ridoluc/RunTiny/hardware/schematics.pdf

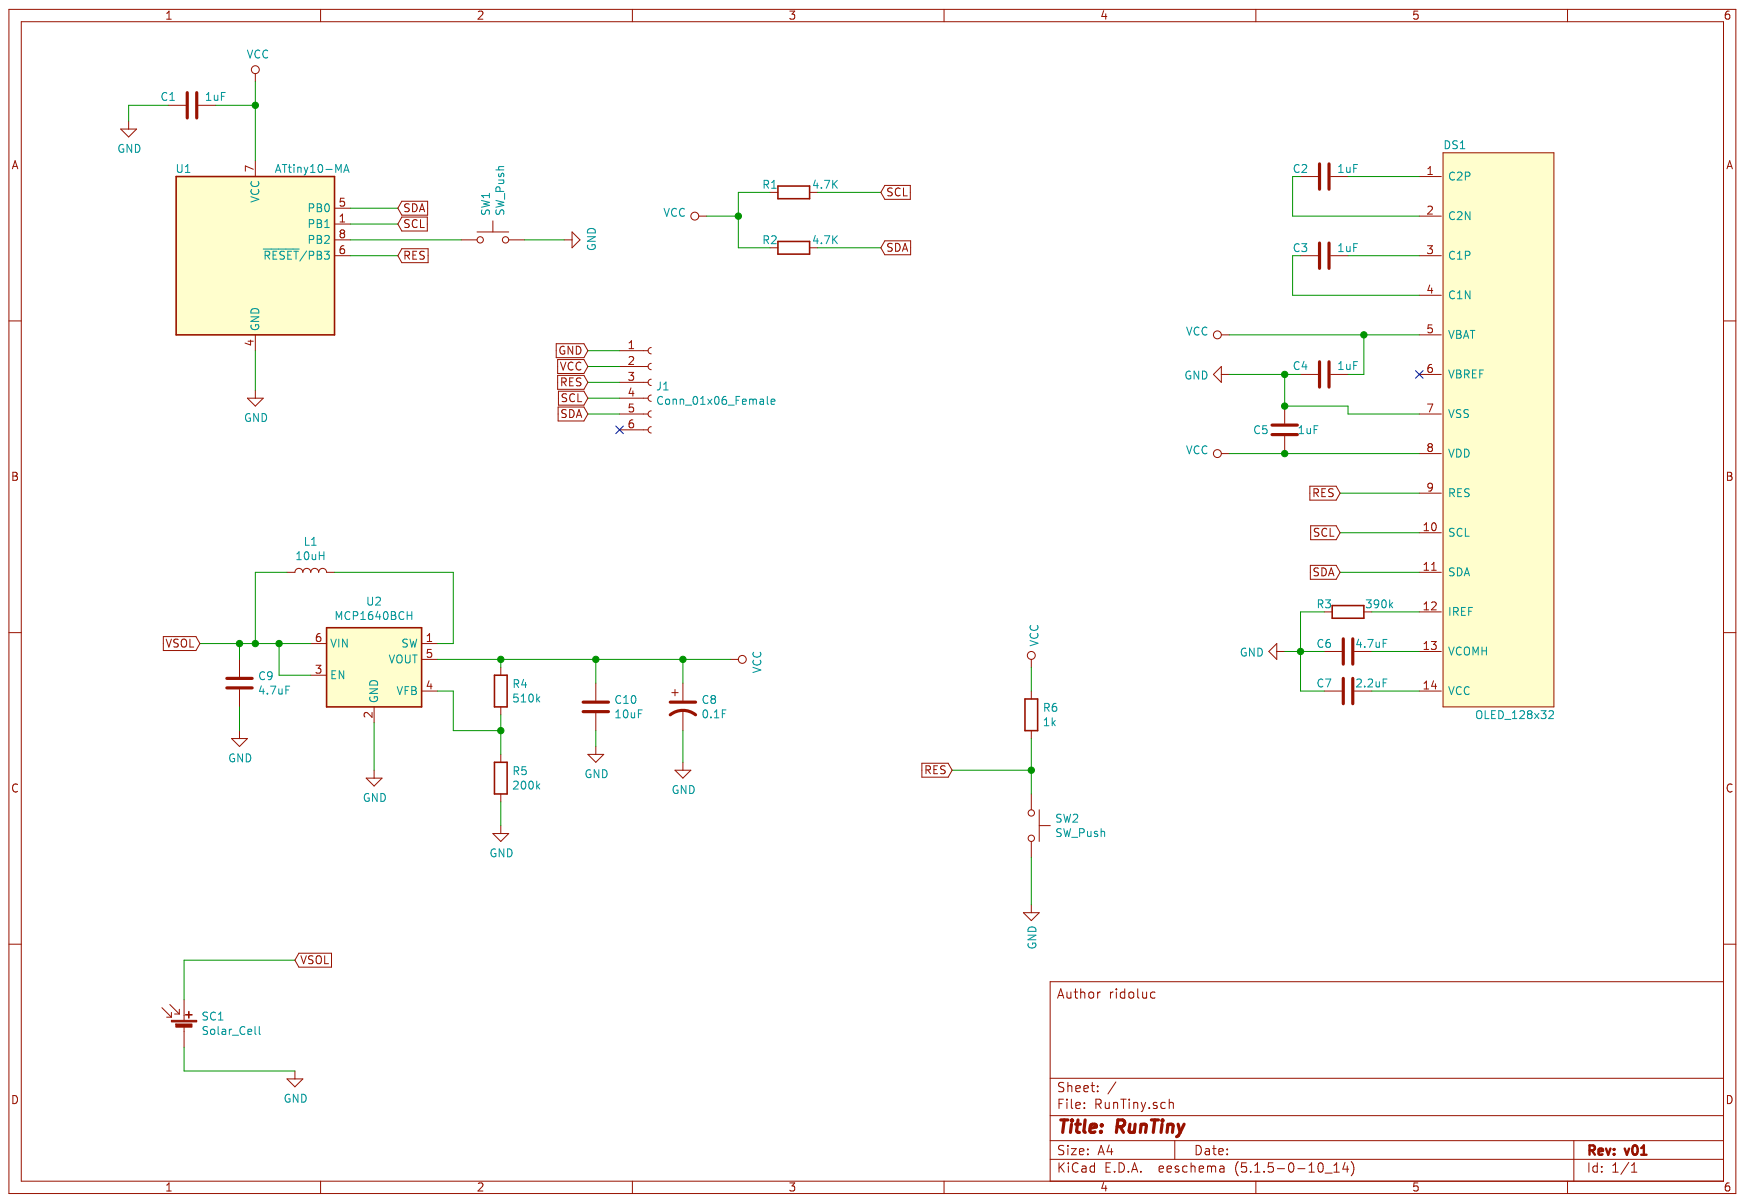
[picture p4: page 1]
