ridoluc/RunTiny/(commit log)

2020-06-07 comunication start and stop inside print function
2020-06-07 print enemies
2020-06-22 changed frame rate
